BLUTEAU-LARTIGUE-G4/Security-Box/Rapports Séances/BLUTEAU Laure-Anne/SEANCE_8-BLUTEAU.pdf

BLUTEAU Laure-Anne G4

## COMPTE RENDU – SÉANCE 8

Lors de cette séance, nous avons changé notre ancienne carte esp32 Heltec Wifi Lora 32 par une esp32 WROOM. J'ai, avec cette nouvelle carte, réussi à faire communiquer l'esp32 WROOM et la arduino UNO. Nous arrivons donc maintenant à faire transiter deux données entre les cartes : une pour la validation de l'ouverture (variable "boite") et l'autre pour la réinitialisation du code, le nouveau code saisi par le propriétaire est alors envoyé (variable "code").

J'ai donc finalement rassemblé tous les codes ensemble pour n'en avoir plus que deux (un pour chaque carte) et refait marcher tous les modules ensemble. L'écran LCD ne fonctionne parfois pas mais ce "bug" doit être dû à un mauvais contact dans un fil : lorsqu'on bouge légèrement l'écran il remarche parfaitement.

Pour l'instant, je ne parviens pas à remplacer l'ancien code par le nouveau, l'ancien étant de type char : char codebon[] = "1234", et le nouveau de type String ou int, on obtient une erreur lors de la compilation (liée aux deux variables de différent type). Il faudrait alors parvenir à "écraser" l'ancien code et remplacer celui-ci par le nouveau directement dans "codebon".

Le code pour la carte maitre (esp32) est le suivant :

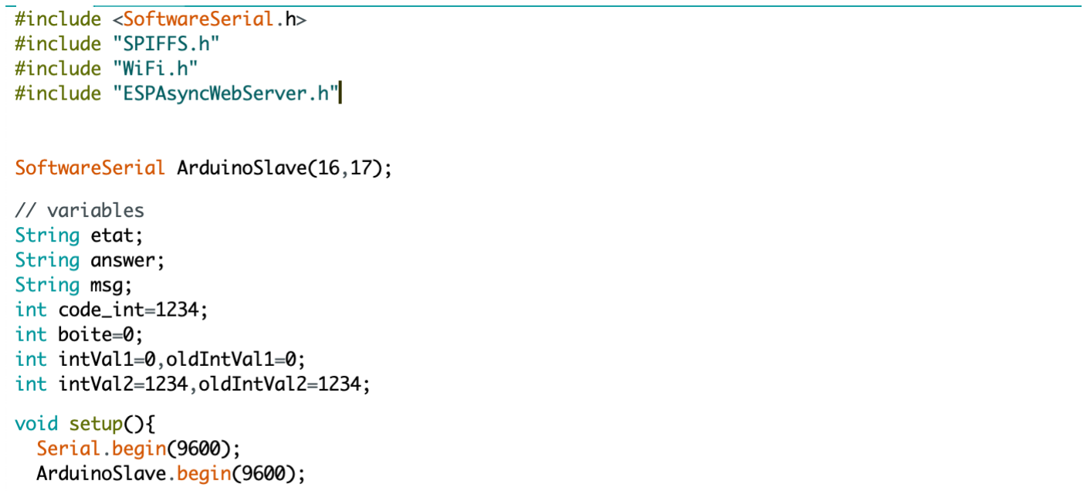
[picture p7: figure]
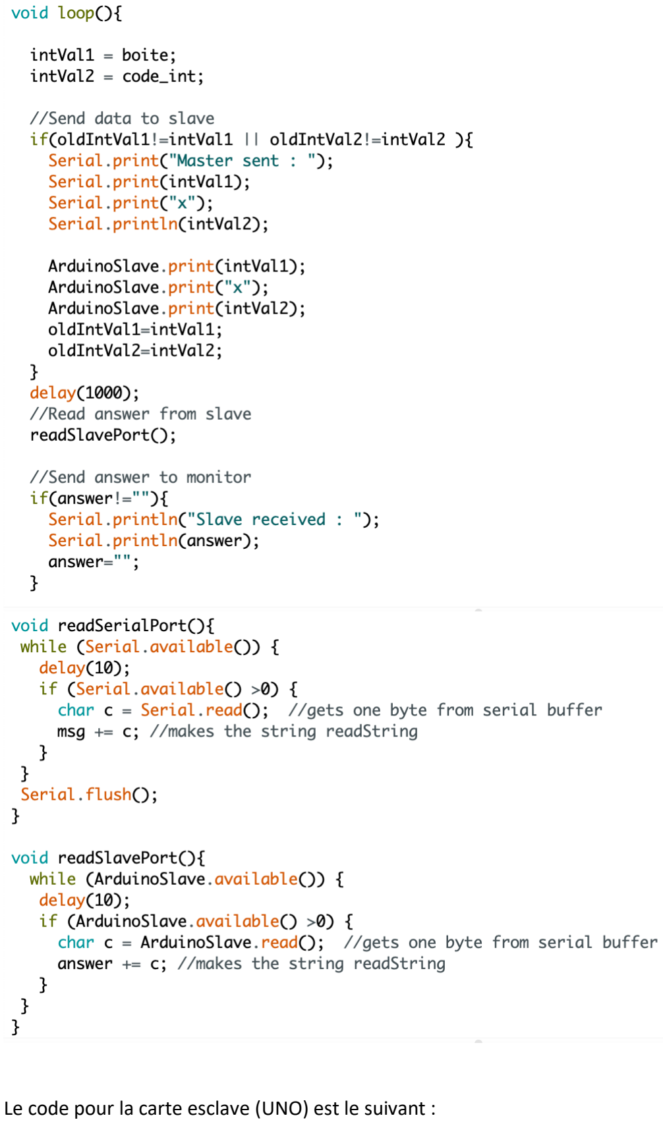
[picture p8: page 2]

Le code pour la carte esclave (UNO) est le suivant :

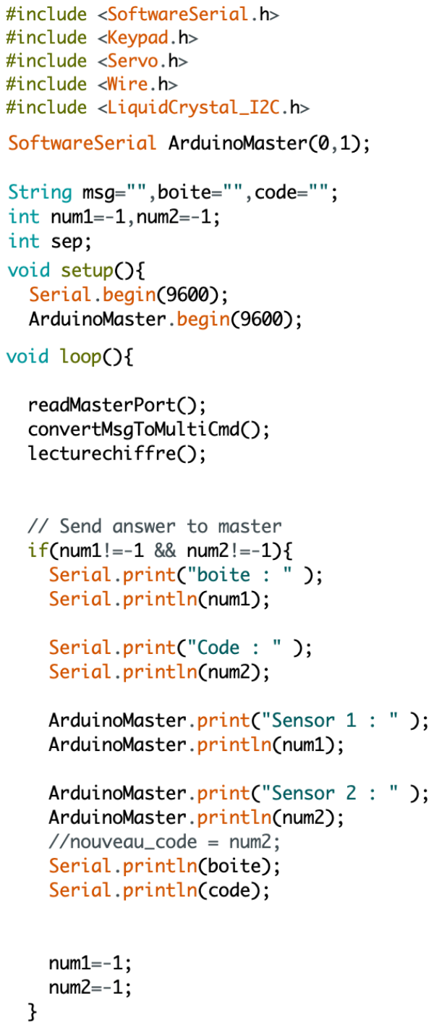
[picture p9: figure]

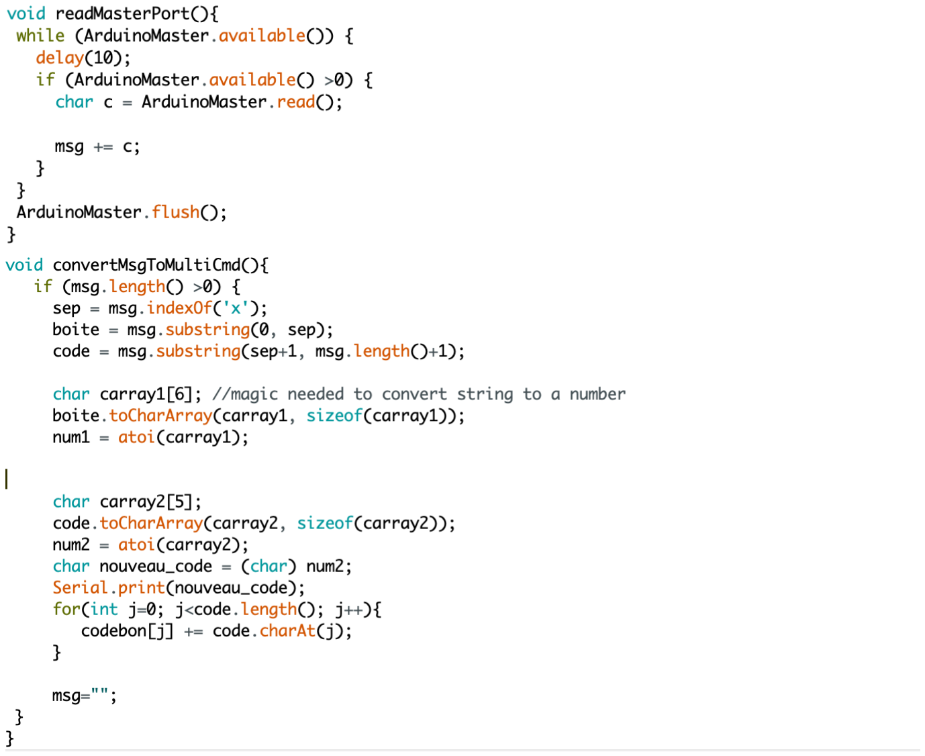
[picture p10: figure]

Les codes ci-dessus ne montrent que les parties servant à la communication entre les deux cartes.

Pour la présentation finale, une autentification pour la page html sera surement ajoutée pour que seul le propriétaire puisse s'y connecter avec des identifiants.
