BLUTEAU-LARTIGUE-G4/Security-Box/Rapports Séances/BLUTEAU Laure-Anne/SEANCE_6-BLUTEAU.pdf

BLUTEAU Laure-Anne G4

COMPTE RENDU – SÉANCE 6

Lors de cette séance, j'ai pu résoudre un problème rencontré sur la carte depuis quelques semaines, avec l'aide de monsieur Peter. Le programme amenait la carte à répéter des lignes de code en continu au lieu de se connecter au réseau. Il s'agissait enfaite d'une carte Heltec Wifi Lora 32 et non d'une Heltec Wifi Lora 32 V2, et le télé versement ne se faisait donc pas sur la bonne carte ce qui entrainait l'erreur précédente. Le problème du partage de connexion est toujours présent mais sera normalement résolu par l'ajout d'une borne wifi au projet qui permettra de connecter la carte au réseau.

J'ai également ajouté quelques lignes au programme de l'ouverture physique de la boite afin d'inclure la validation à distance du propriétaire dans le code.

CODE CARTE UNO

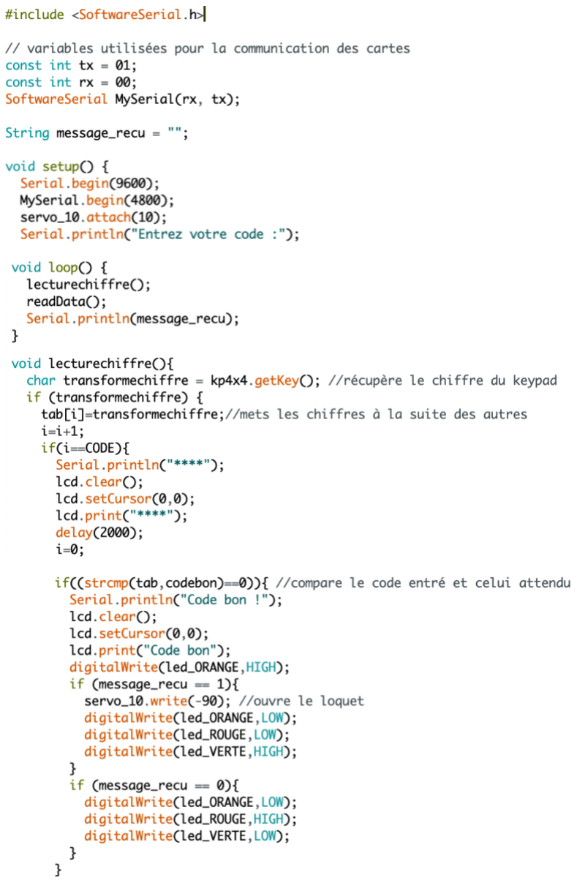
[picture p18: figure]

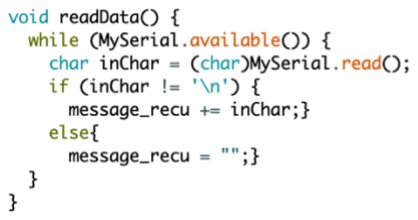
[picture p19: figure]

Ce code n'est pas celui complet, il montre simplement les lignes permettant de récupérer les informations envoyées par la carte ESP32 et de les ajouter à une variable (message_recu) sur la UNO afin d'autoriser ou non l'ouverture de la boite. Lorsque le propriétaire autorise l'ouverture à distance, l'ESP32 envoi un "1" à la UNO, dans le cas contraire un "0".

CODE CARTE ESP32

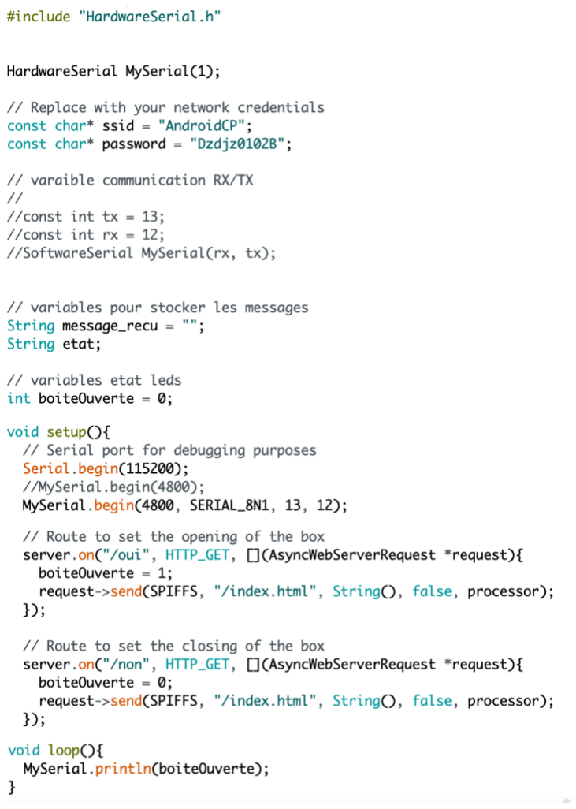
[picture p20: figure]

Ce code n'est également pas celui complet et montre seulement les lignes de codes permettant la communication. Ici lorsque la propriétaire autorise l'ouverture la variable "boiteOuverte" prend la valeur 1, à l'inverse 0. La variable est ensuite envoyée sur "MySerial", moniteur série commun aux deux cartes permettant le transfert de données de l'ESP32 vers la UNO.

Monsieur Peter nous a également conseillé de tout rassembler sur l'ESP32 afin d'éviter la communication entre les deux cartes (qui ne marche pas encore) et de n'en garder qu'une. Nous avions décidé d'utiliser deux cartes par peur de manque de place mais il s'avère que tous les appareils pourraient être câblés sur l'ESP32 mais aussi car nous n'avions pas de bibliothèque compatible avec la carte Wifi pour certains composants comme le servo moteur. Nous essaierons donc pendant les vacances de tout rassembler sur une carte ou à default de faire marcher la communication.

Nous avons également prévu, avec Elisa pour qu'il ne reste plus qu'aux dernières séances à régler les derniers problèmes et tout installer dans la boite.
