BLUTEAU-LARTIGUE-G4/Security-Box/Rapports Séances/LARTIGUE Elisa/SEANCE 5 LARTIGUE PROJET ARDUINO.pdf

### SEANCE 5 PROJET ARDUINO – ELISA LARTIGUE

Cette séance était pour nous une séance de groupe, l’occasion de nous montrer les problèmes respectifs que nous rencontrions et de nous mettre d’accord sur les modalités de la création de la boîte.

Laure Anne rencontrait quelques soucis pour faire discuter la carte ESP32 avec la carte UNO. L’objectif était de déclencher l’ouverture de la boîte en fonction d’une information envoyée de l’ESP32 à la carte UNO. Pendant qu’elle tentait plusieurs bibliothèques et mixait plusieurs codes, j’ai de mon côté, travaillé sur l’état des LED en fonction de la décision envoyée par l’ESP32.

Montage

La led verte ne figure pas sur ce montage car elle ne présente pas d’intérêt en l’absence du code de l’ESP32. En effet, la led verte s’allume si et seulement si le code tapé sur le digicode est le bon et que le propriétaire valide l’action. Ce montage ne correspond qu’au code de la carte uno.

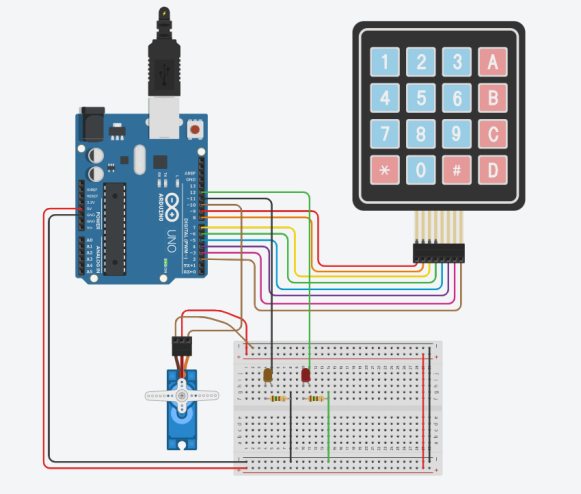
[picture p26: figure]

J’ai joué sur la couleur des leds en fonction du code tapé. Lorsque le code tapé est bon, la led orange s’allume jusqu’à validation par le propriétaire (dans ce cas la led orange s’éteint, la led verte s’allume et la porte s’ouvre) et si le code est faux, la led rouge s’allume pendant les trois essais supplémentaires disponibles, et s’éteint à la fin des trois essais si le code tapé reste faux (ou est remplacé par la led orange si le code tapé est bon et que l’on attend la réponse du propriétaire).

Monsieur Peter nous a rejoint en réponse à un de nos mails et après lecture de notre code, nous a conseillé d’essayer une nouvelle bibilothèque : Serial.hardware. Nous devons nous pencher sur cette bibliothèque pour savoir comment elle fonctionne.

Nous nous sommes ensuite rendues dans le fablab afin de nous mettre d’accord sur les dimensions et les matériaux que nous utiliserons la semaine prochaine pour la conception de la boîte. Nous avons choisi de faire notre boîte dans un bois épais que nous peindrons en noir. D’une hauteur de 20 cm, il présentera deux compartiments. Un pour le matériel électronique et l’autre pour le coffre.

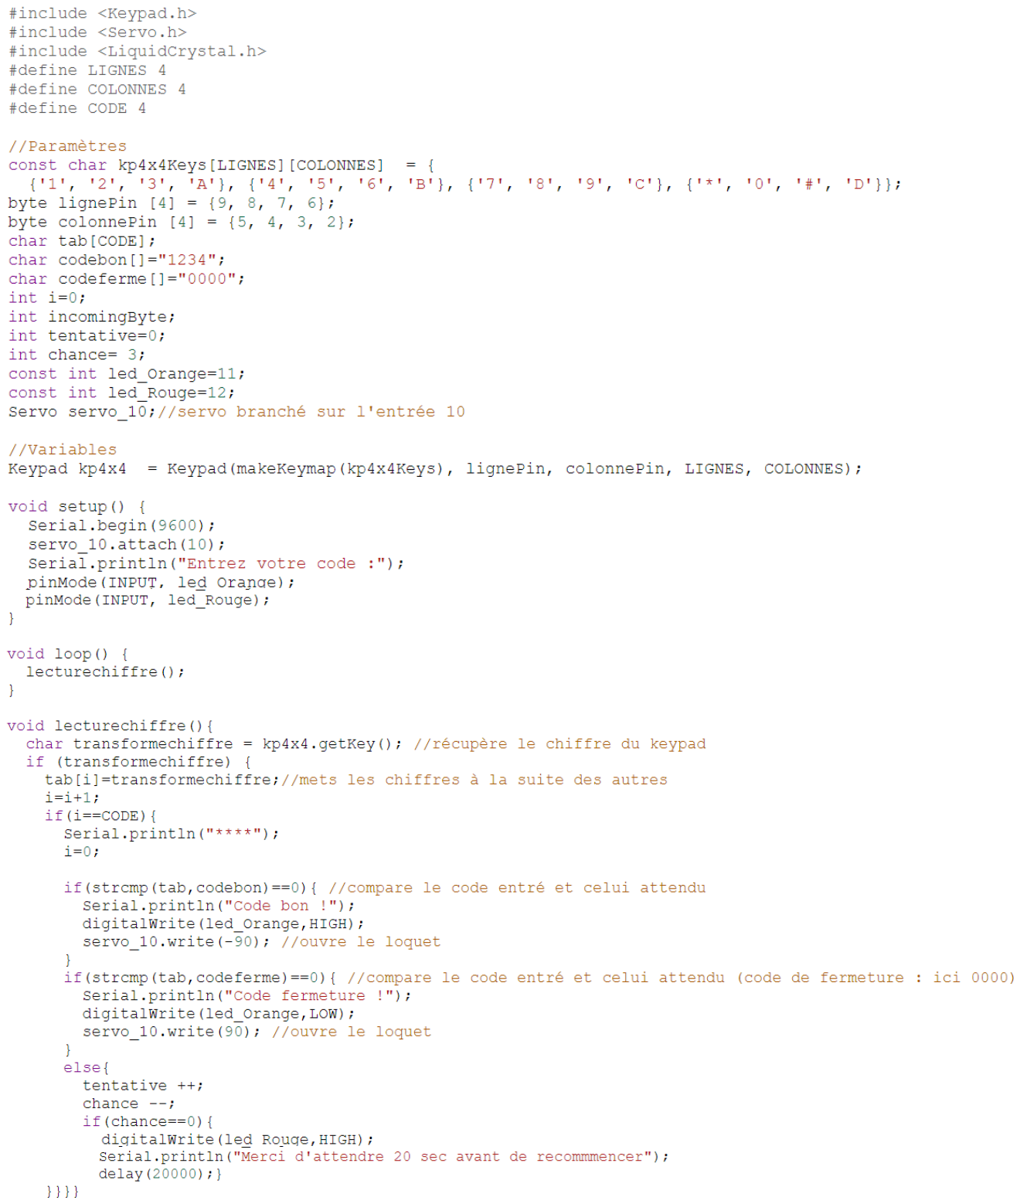
[picture p27: figure]
