BLUTEAU-LARTIGUE-G4/Security-Box/Rapports Séances/LARTIGUE Elisa/SEANCE 4 LARTIGUE PROJET ARDUINO.pdf

### SEANCE 4 PROJET ARDUINO – ELISA LARTIGUE

Cette séance était dédiée à la présentation du projet et du réglages de nos derniers problèmes. Nous avions à l’origine deux cartes, une carte ESP8266 (qui gérait l’allumage d’une LED à distance) et une carte arduino (qui en fonction de la LED allumée, ouvrait ou non le servo moteur). Toutefois, Monsieur Peter ne comprenait pas l’utilisation de ces deux cartes et nous avait conseillé de tout regrouper sur une troisième carte ESP32 pour éviter que nos programmes prennent trop de temps à charger. Toutefois, la librairie du servo moteur et du keypad ne semblent pas convenir à cette carte. Nous avons donc gardé les deux cartes que nous essayons de faire dialoguer toutes les deux grâce au port TX et RX.

LED ORANGE

J’ai tout d’abord ajoutée une LED orange au montage. Une fois le code correctement tapé par l’utilisateur, une LED orange s’allume, dans l’attente de la réponse du propriétaire du coffre qui valide, ou non, son ouverture.

Code ajouté + montage:

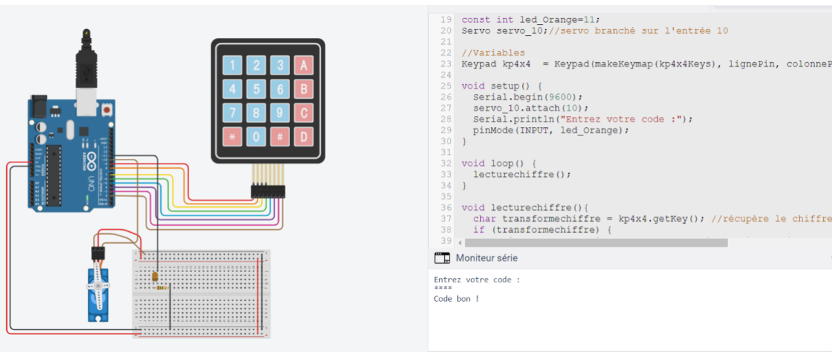
[picture p28: figure]

Modification du code : simple ajout d’une LED orange qui s’allume lorsque le code est bon comme vu en TD au début du module. Ici la LED est allumée car le code tapé est le bon.

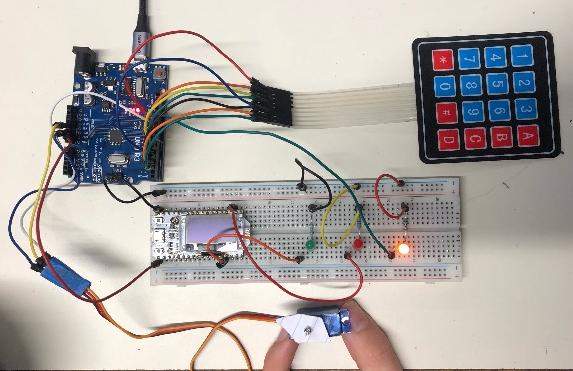
[picture p29: figure]

FERMETURE DU COFFRE

J’ai ensuite ajouté un code au code originel afin que le coffre puisse être fermé lorsque l’utilisateur tape « 0000 ».

Modification du code :

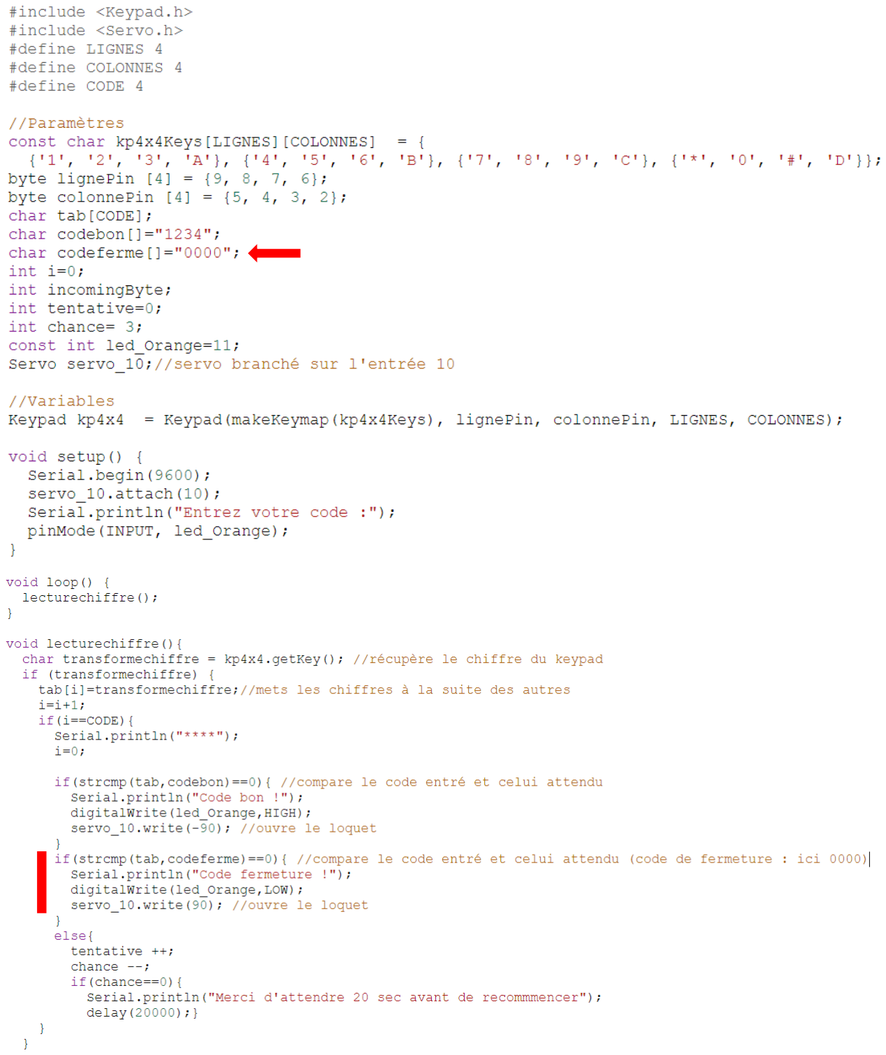
[picture p30: figure]

VOIR PAGE SUIVANTE

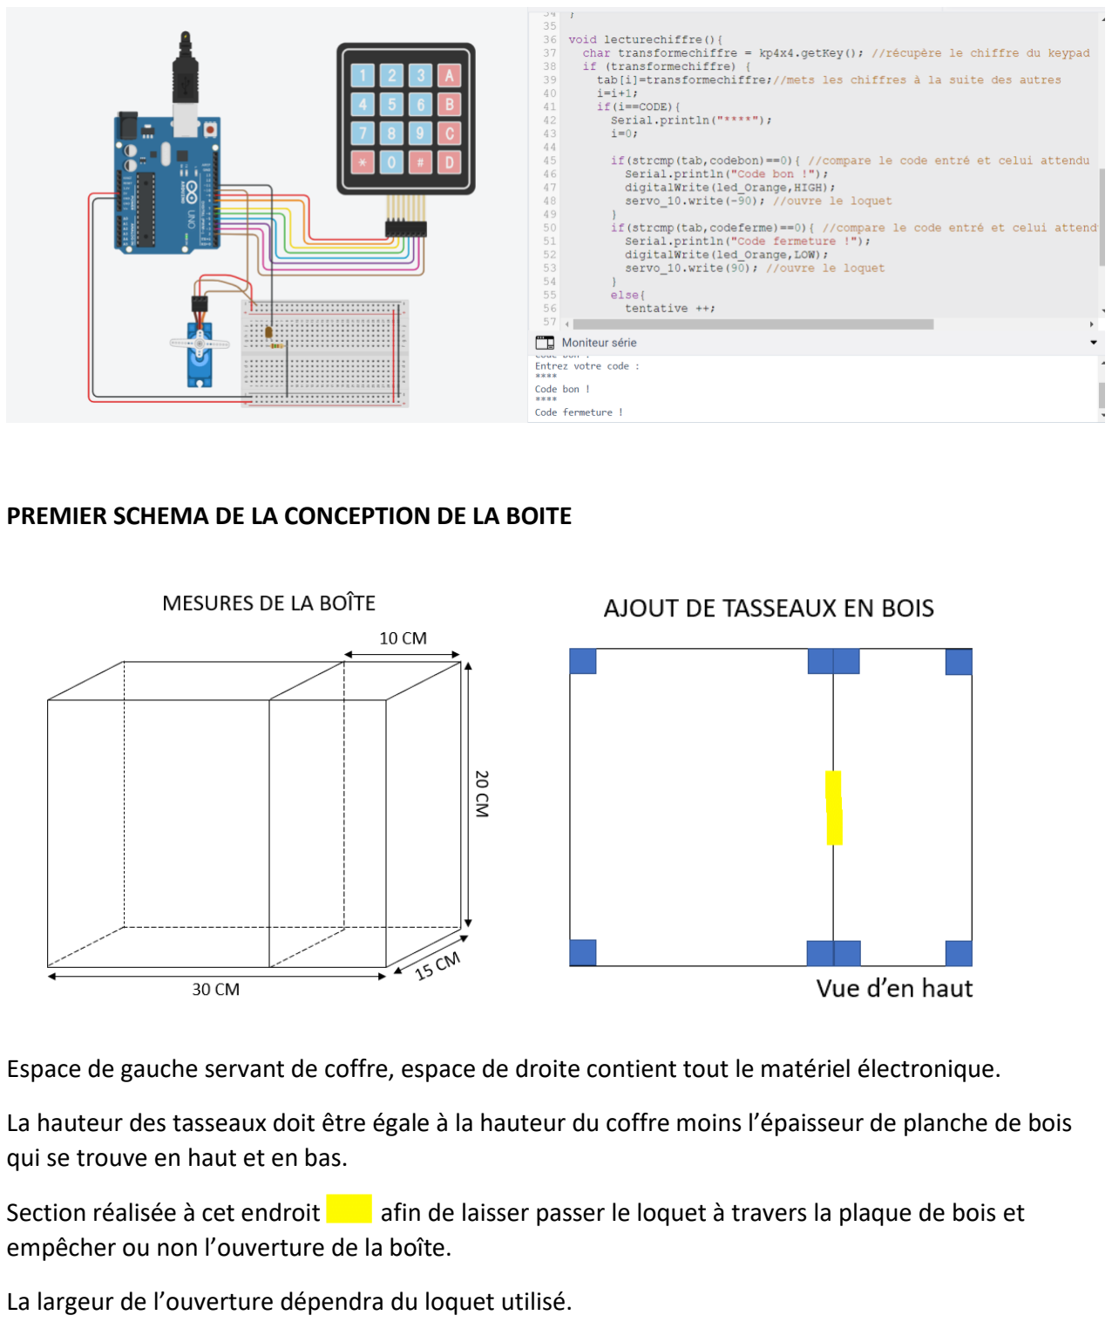
[picture p31: page 3]

PREMIER SCHEMA DE LA CONCEPTION DE LA BOITE

Espace de gauche servant de coffre, espace de droite contient tout le matériel électronique.

La hauteur des tasseaux doit être égale à la hauteur du coffre moins l’épaisseur de planche de bois qui se trouve en haut et en bas.

Section réalisée à cet endroit afin de laisser passer le loquet à travers la plaque de bois et empêcher ou non l’ouverture de la boîte.

La largeur de l’ouverture dépendra du loquet utilisé.
