BLUTEAU-LARTIGUE-G4/Security-Box/Rapports Séances/LARTIGUE Elisa/SEANCE 3 LARTIGUE PROJET ARDUINO.pdf

### SEANCE 3 PROJET ARDUINO – ELISA LARTIGUE

Pour cette séance, je devais m’occuper de permettre à l’utilisateur de modifier le mot de passe pour ouvrir le coffre, à distance. Prenons l’exemple de Monsieur X qui loue son appartement à Nice pendant les vacances. Monsieur X est à Paris. Le coffre se trouve devant l’appartement à loué et contient les clés. Une famille loue son appartement du 1er juin au 4 juin. Le 5, pour éviter que cette même famille ait la possibilité de revenir dans l’appartement alors qui est loué par quelqu’un d’autre, Monsieur X a la possibilité de changer le mot de passe du coffre.

SCHEMA EXPLICATIF :

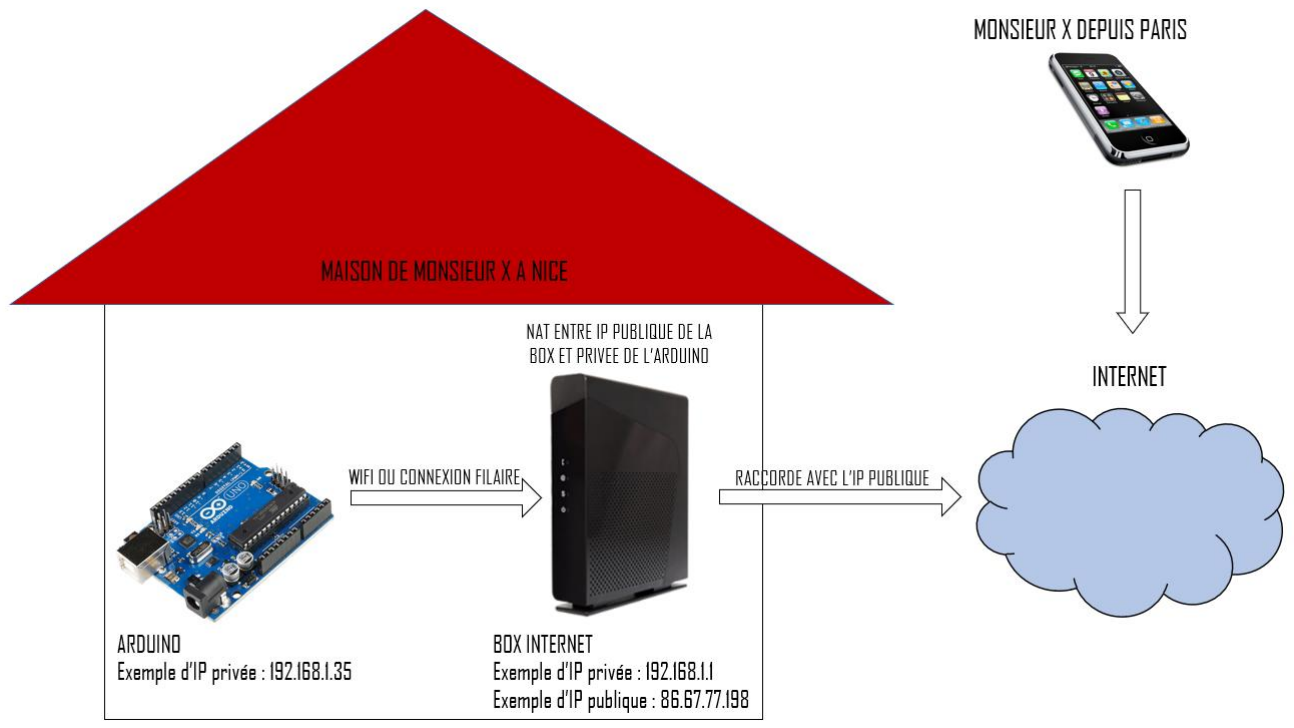
[picture p36: figure]

1. Monsieur X se rend sur internet et tappe dans la barre de recherche son adresse IP publique de la box sous la forme suivante « http:// 86.67.77.198 (https://whatismyipaddress.com/ip/86.67.77.198) ».
2. La box, étant accessible sur Internet et l’adresse IP publique de la box étant natée avec l’adresse privée de l’arduino, Monsieur X peut « agir » sur l’arduino (ici changer le mot de passe attendue par notre coffre).

J’ai ensuite créé une page HTML avec un espace prévu afin que l’utilisateur entre son nouveau mot de passe. Une fois le nouveau mot de passe enregistré, il est envoyé à l’arduino via l’URL.

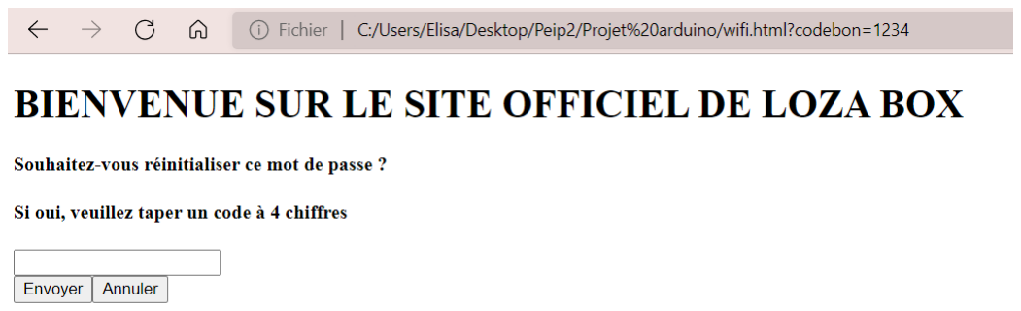
[picture p37: figure]

Ici j’ai tapé le code 1234, et on peut voir qu’il apparait dans le variable appelée codebon.

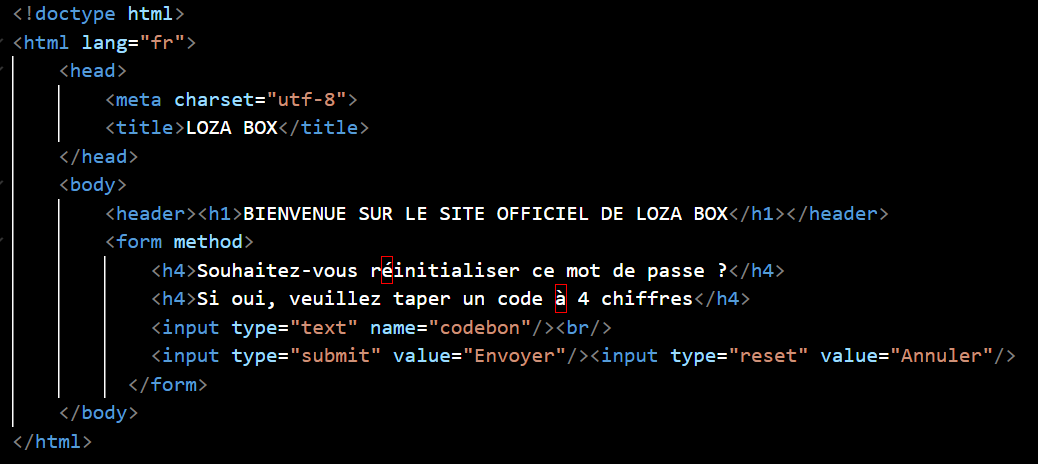
[picture p38: figure]

Je me suis alors rendu compte que si une personne réussissait à obtenir l’adresse IP publique de l’appartement de Monsieur X, il pourrait hacker le système. J’ai donc cherché à ajouter une vérification d’identité avant que l’utilisateur puisse modifier le mot de passe.

CODE SUIVANT :

J’ai d’abord défini les paramètres d’identification : nom d’utilisateur et mot de passe.

const char* http_username = "admin";
const char* http_password = "admin";

Je dois tester ce code pour permettre l’identification du propriétaire avant qu’il confirme ou refuse l’ouverture de la boîte. J’attends la semaine prochaine pour le tester sur notre code final.

server.on("/", HTTP_GET, [](AsyncWebServerRequest *request){ if(!request->authenticate(http_username, http_password))
return request->requestAuthentication(); request->send_P(200, "text/html", index_html, processor);
});

server.on("/logout", HTTP_GET, [](AsyncWebServerRequest *request){ request->send(401);
});

server.on("/logged-out", HTTP_GET, [](AsyncWebServerRequest *request){ request->send_P(200, "text/html", logout_html, processor);
});

server.on("/update", HTTP_GET, [] (AsyncWebServerRequest *request) { if(!request->authenticate(http_username, http_password))
return request->requestAuthentication();

String inputMessage;
String inputParam;
// GET input1 value on <ESP_IP>/update?state=<inputMessage> if (request->hasParam(PARAM_INPUT_1)) {
inputMessage = request->getParam(PARAM_INPUT_1)->value(); inputParam = PARAM_INPUT_1;
digitalWrite(output, inputMessage.toInt());
}
else {
inputMessage = "No message sent”; inputParam = "none";
}
Serial.println(inputMessage); request->send(200, "text/plain", "OK"); });

// Start server
server.begin();

Nous avons ensuite, avec Laure Anne, testé nos deux codes ensemble. Si Monsieur X accepte l’ouverture de la boîte à distance alors une LED verte s’allume sur notre coffre. Pour que celui-ci s’ouvre, la présence d’un code non erroné et de la LED verte allumée sont nécessaires.

Laure Anne simulait la confirmation de l’ouverture par Monsieur X en allumant la LED verte via internet. J’ai ajouté cette condition pour l’ouverture du servomoteur.

MONTAGE + CODE (modification des conditions à la ligne 9):

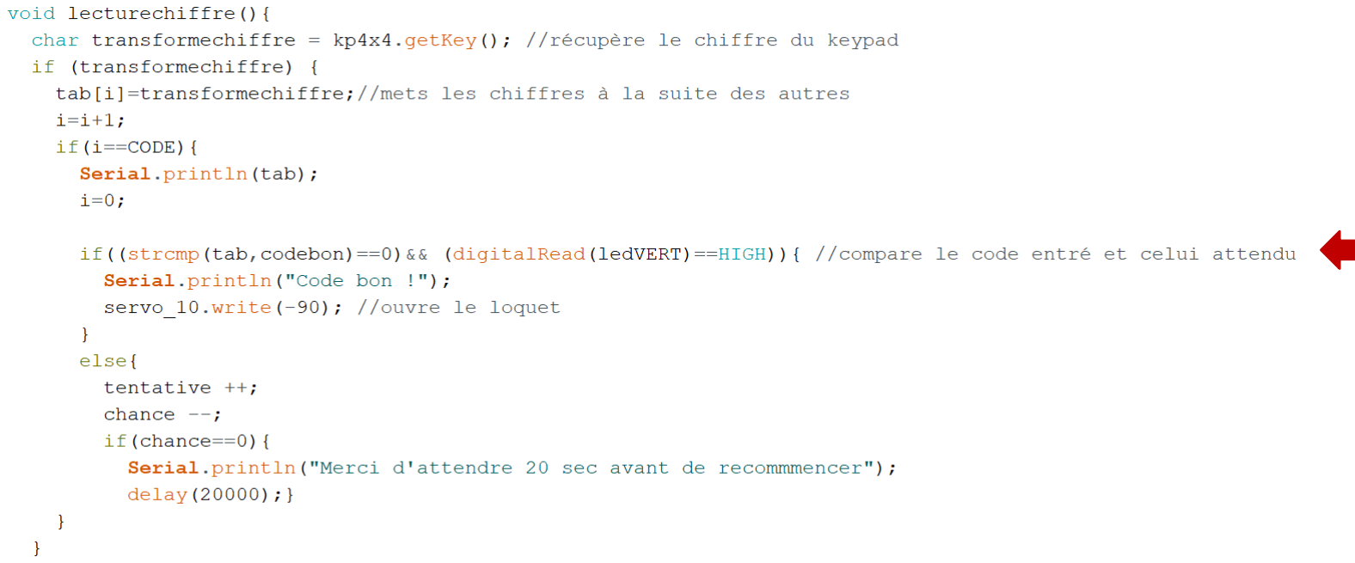
[picture p39: figure]
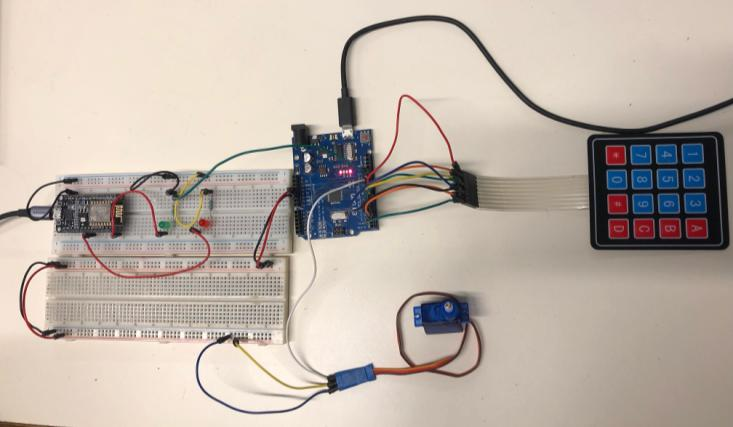
[picture p40: figure]

Problème rencontré : une fois nos deux codes liés, la page de Laure Anne prenait beaucoup de temps à charger, il nous faut donc au prochain cours mettre nos deux codes sur une même page et choisir une même carte commune. Nous avons choisi une ESP32.
