BLUTEAU-LARTIGUE-G4/Security-Box/Rapports Séances/LARTIGUE Elisa/SEANCE 2 LARTIGUE PROJET ARDUINO.pdf

### SEANCE 2 PROJET ARDUINO – ELISA LARTIGUE

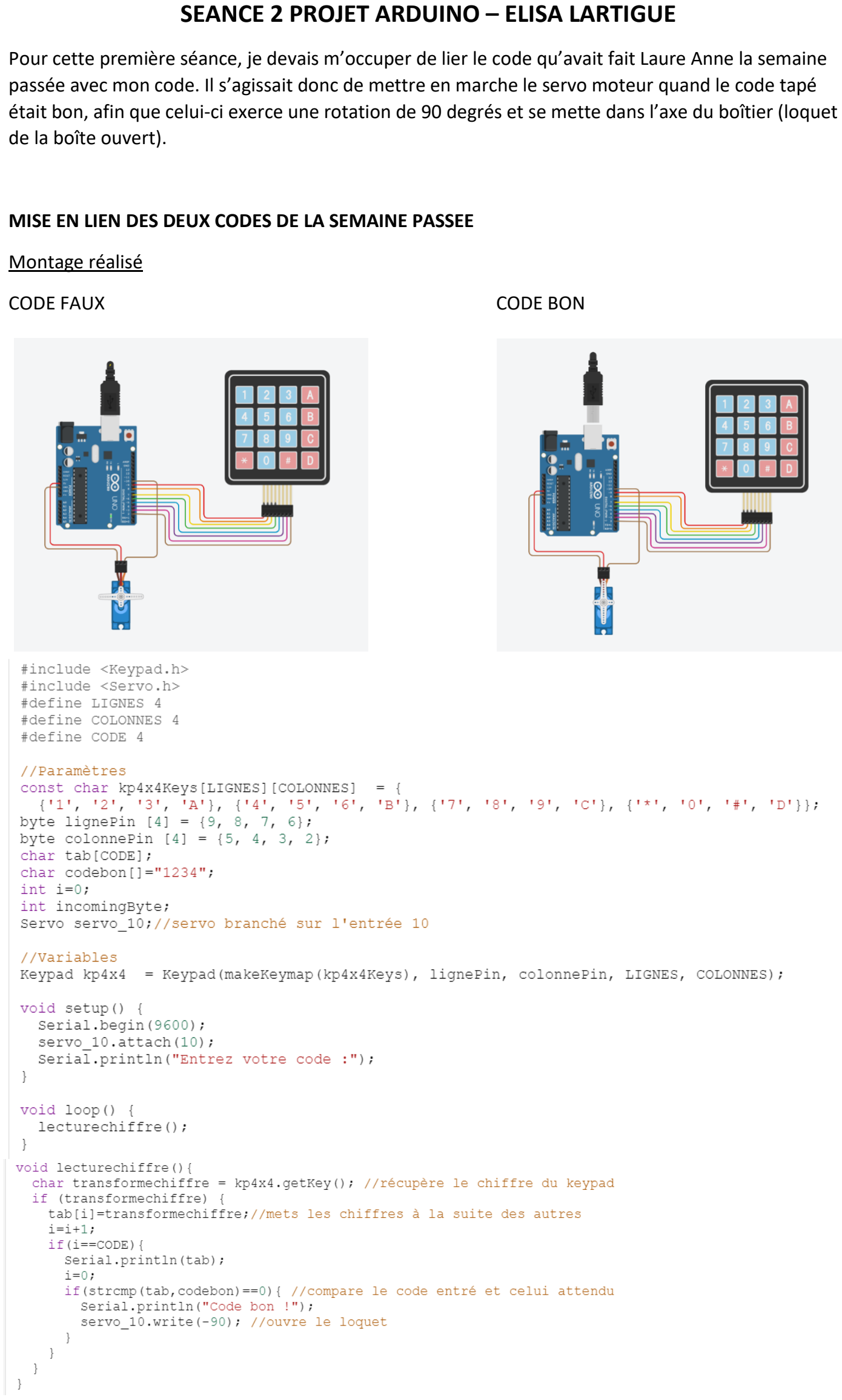
[picture p44: page 1]

Pour cette première séance, je devais m’occuper de lier le code qu’avait fait Laure Anne la semaine passée avec mon code. Il s’agissait donc de mettre en marche le servo moteur quand le code tapé était bon, afin que celui-ci exerce une rotation de 90 degrés et se mette dans l’axe du boîtier (loquet de la boîte ouvert).

MISE EN LIEN DES DEUX CODES DE LA SEMAINE PASSEE

Montage réalisé

CODE FAUX | CODE BON

Pour ce code, j’ai simplement ordonné au servo moteur de réaliser une rotation de 90 degrés lorsque le code était bon. J’ai donc entré dans la condition du code bon (servo_10.write(-90) ;)

Mixer les deux codes de la semaine passée s’est révélé plus rapide que prévu. J’ai donc décidé de rajouter quelques options :

-bloquer la possibilité de tenter le code pendant 20 secondes (pour que ça ne soit pas trop long pour les tests, 5min dans la réalité) après trois tentatives de code erroné.

-cacher le code à l’aide d’étoiles.

AJOUT D’OPTIONS

1) Bloquer la possibilité de tenter le code pendant 20 secondes après trois tentatives de code erroné.

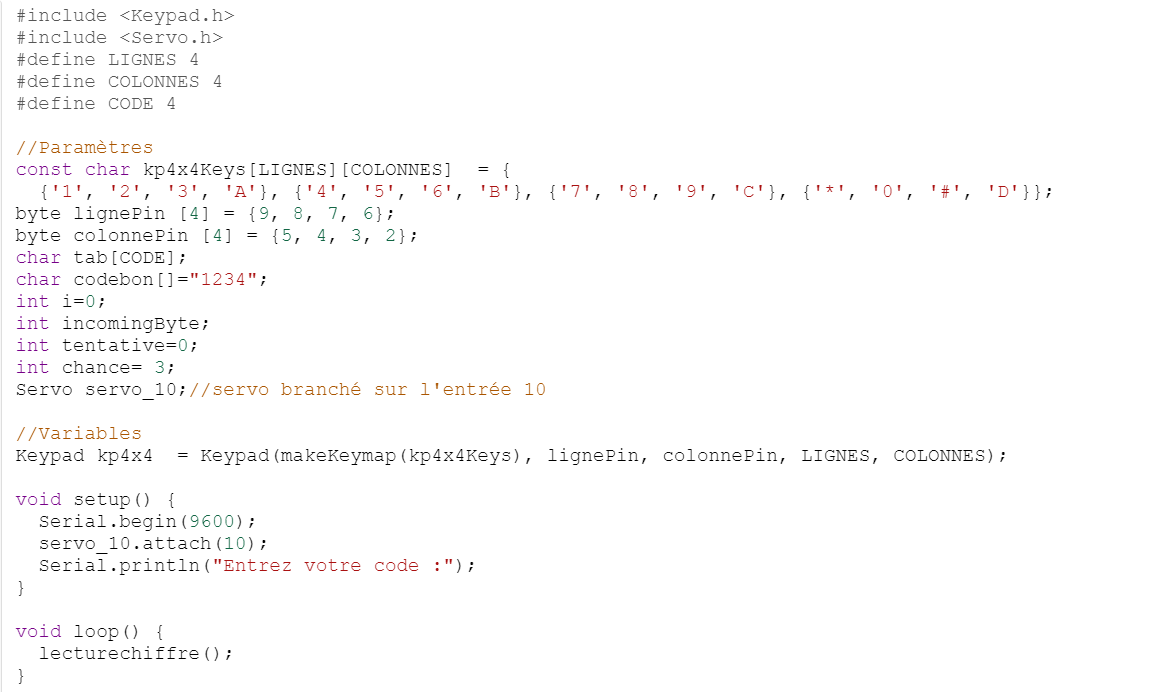
[picture p45: figure]
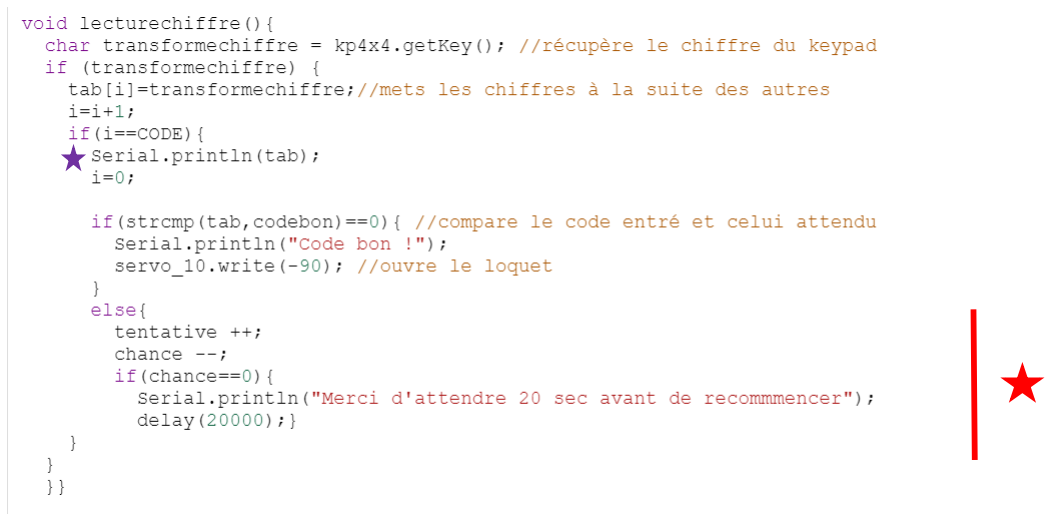
[picture p46: figure]

Ajout de deux variables : chance (qui me permet de bloquer l’accès au code quand trop de tentatives erronées) et tentatives (qui me servira plus tard pour l’écran LCD).

Ajout d’un délai de 20 secondes lorsque le nombre de chances restantes vaut 0.

Résultat obtenu :

2) Cacher le code à l’aide d’étoiles.

Simple modification de la ligne en Serial.println(« **** ») ;

Résultat obtenu :

3) Demander de retaper le code pour fermer le servomoteur

Modification de cette partie du code. J’ai fixé le code de fermeture au code suivant : 4321.
On me demande bien de retaper le code pour refermer. Mais l’ordinateur ne reconnaît pas le code bon à la fermeture, et n’actionne donc pas le servomoteur. Je dois régler ce souci pour le prochain cours.

Montages que je n’avais pas réussi à faire la semaine dernière, dû à un problème de bibliothèque (mauvaise bibliothèque téléchargée)

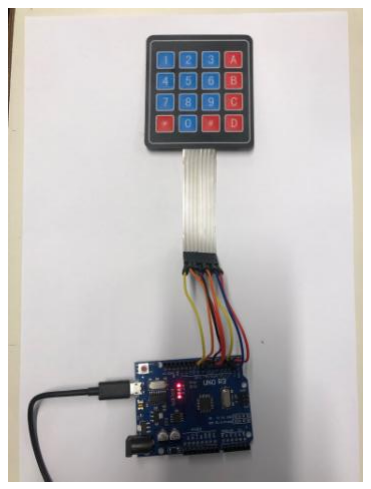
[picture p47: figure]

1) Premier montage : montage du keypad seul.

Permet d’obtenir les chiffres tapés sur le keypad, sur le terminal.

2) Second montage : montage du keypad seul avec le servomoteur.

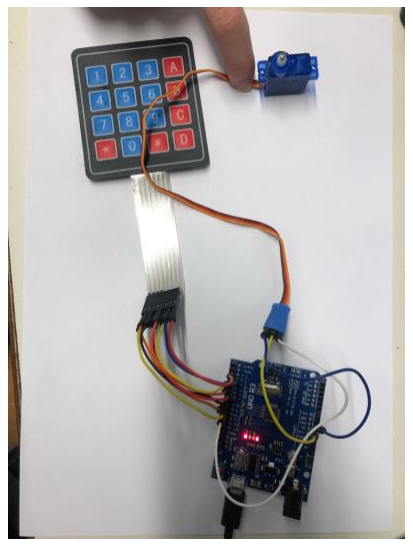
[picture p48: figure]

Permet de faire tourner le servomoteur(ouverture/fermeture de la boîte) en fonction du code tapé.
