BLUTEAU-LARTIGUE-G4/Security-Box/PRESENTATION_ARDUINO.pdf

# LOZA SECURITY BOX

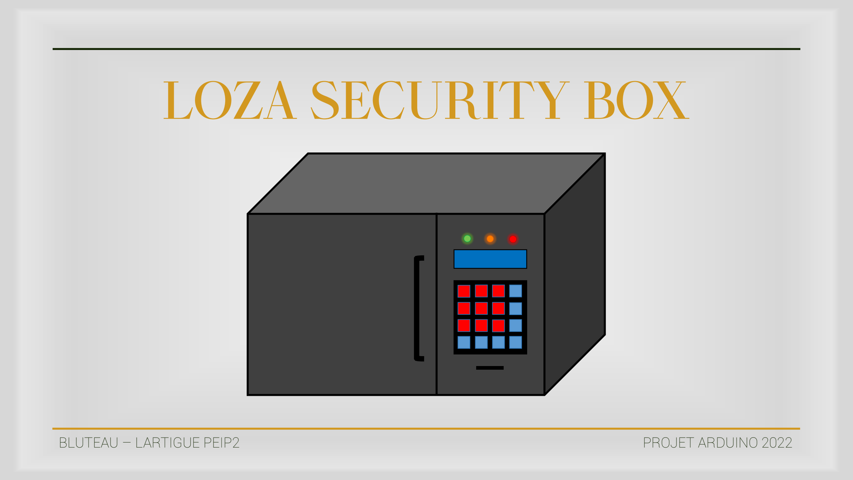
[picture p52: page 1]

BLUTEAU – LARTIGUE PEIP2 | PROJET ARDUINO 2022

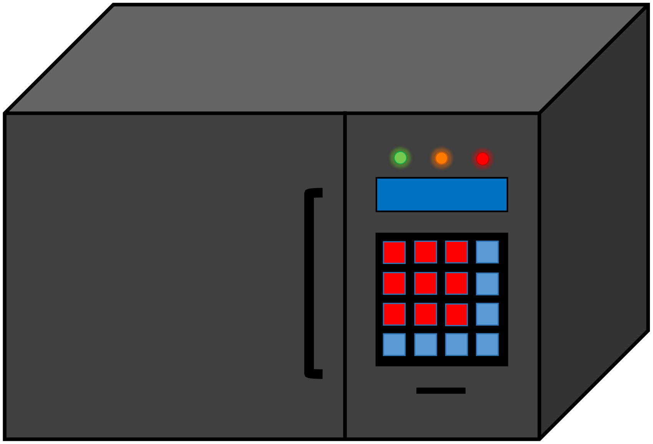
[picture p53: figure]

BLUTEAU – LARTIGUE PEIP2 | PROJET ARDUINO 2022

PRÉSENTATION GÉNÉRALE

BOITE SÉCURISÉE

SYSTÈME LUMINEUX

CODE DIGITAL

COMMUNICATION PAR WIFI
AVEC LE PROPRIÉTAIRE

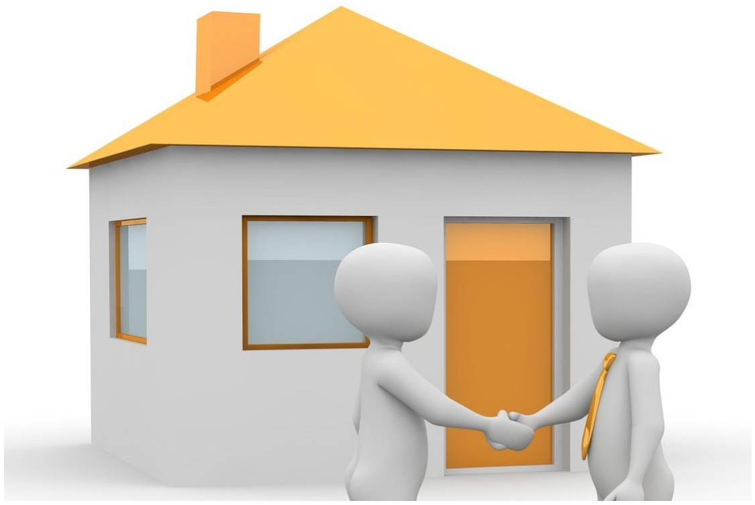
[picture p54: figure]

BLUTEAU – LARTIGUE PEIP2 | PROJET ARDUINO 2022

UTILISATIONS POSSIBLES

La LOZA SÉCURITY BOX pourrait être utilisée :

pour la location saisonnière afin de faire passer les clés du propriétaire au locataire ;

à des fins personnelles.

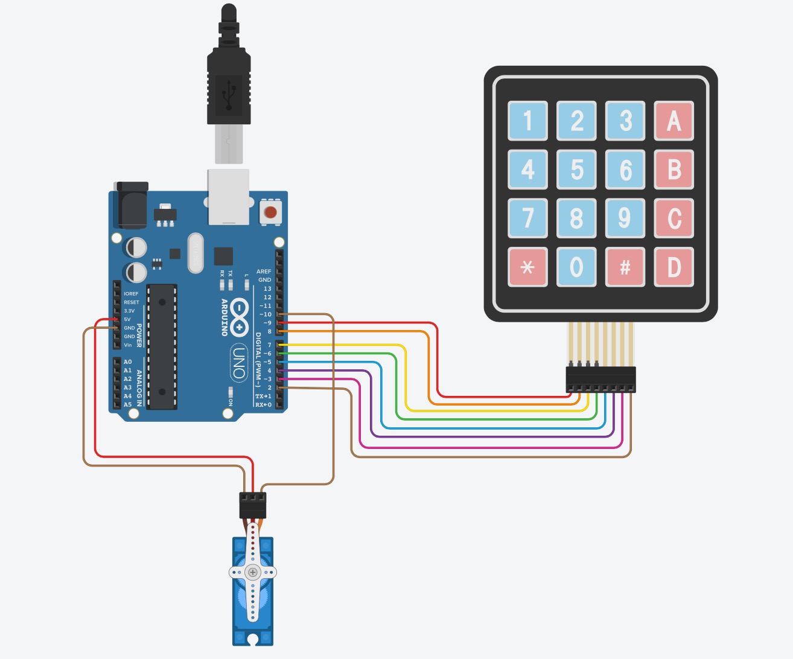
[picture p55: figure]

BLUTEAU – LARTIGUE PEIP2 | PROJET ARDUINO 2022

ÉTAPES DE RÉALISATION

1ère ÉTAPE : SYSTÈME D’OUVERTURE ET DE FERMETURE

OUVERTURE

FERMETURE

Lorsqu’un code bon est saisit, le servomoteur effectue une rotation de 90° et ouvre ainsi la boîte.

Lorsque le code fermeture est saisit, le servomoteur effectue une rotation de 90° bloquant ainsi la porte.

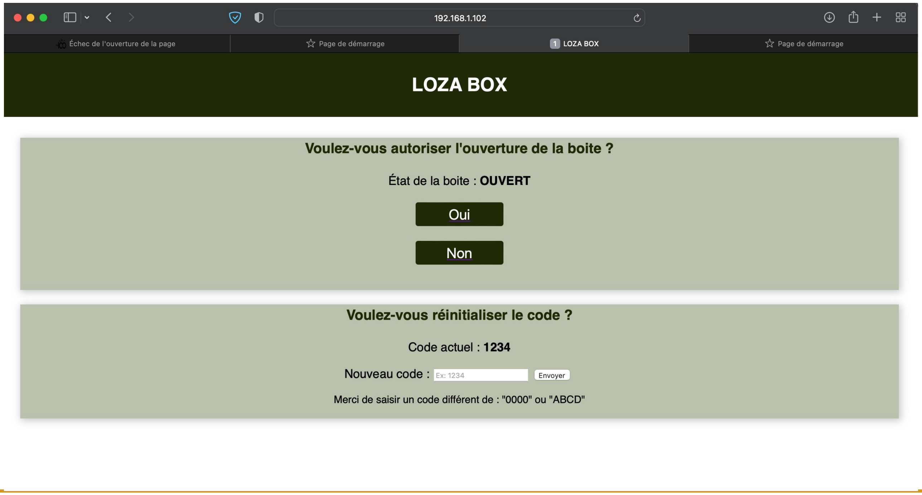
[picture p56: figure]

BLUTEAU – LARTIGUE PEIP2 | PROJET ARDUINO 2022

ÉTAPES DE RÉALISATION

2ème ÉTAPE : CRÉATION D’UNE CONNEXION WIFI

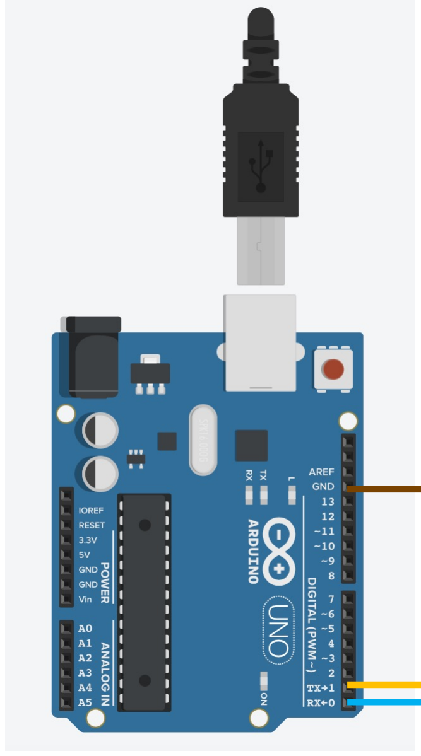
[picture p57: figure]
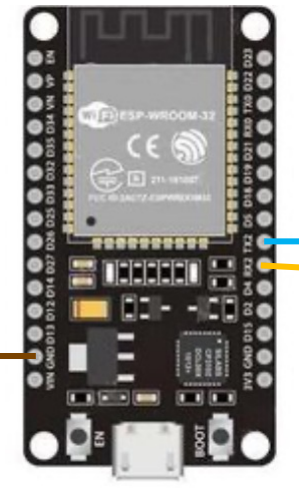
[picture p58: figure]

BLUTEAU – LARTIGUE PEIP2 | PROJET ARDUINO 2022

ÉTAPES DE RÉALISATION

3ème ÉTAPE : CONNEXION ENTRE LES DEUX CARTES

INFORMATIONS À ENVOYER

ESP32

UNO

Nouveau code | Validation ou non de l’ouverture de la boite

Lecture et implémentation dans des variables

+

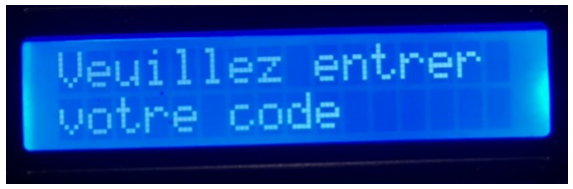
[picture p59: figure]
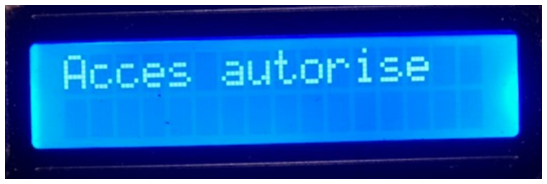
[picture p60: figure]
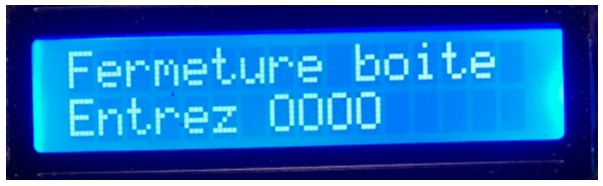
[picture p61: figure]

BLUTEAU – LARTIGUE PEIP2 | PROJET ARDUINO 2022

ÉTAPES DE RÉALISATION

4ème ÉTAPE : PERFECTIONNEMENT DU SYSTÈME

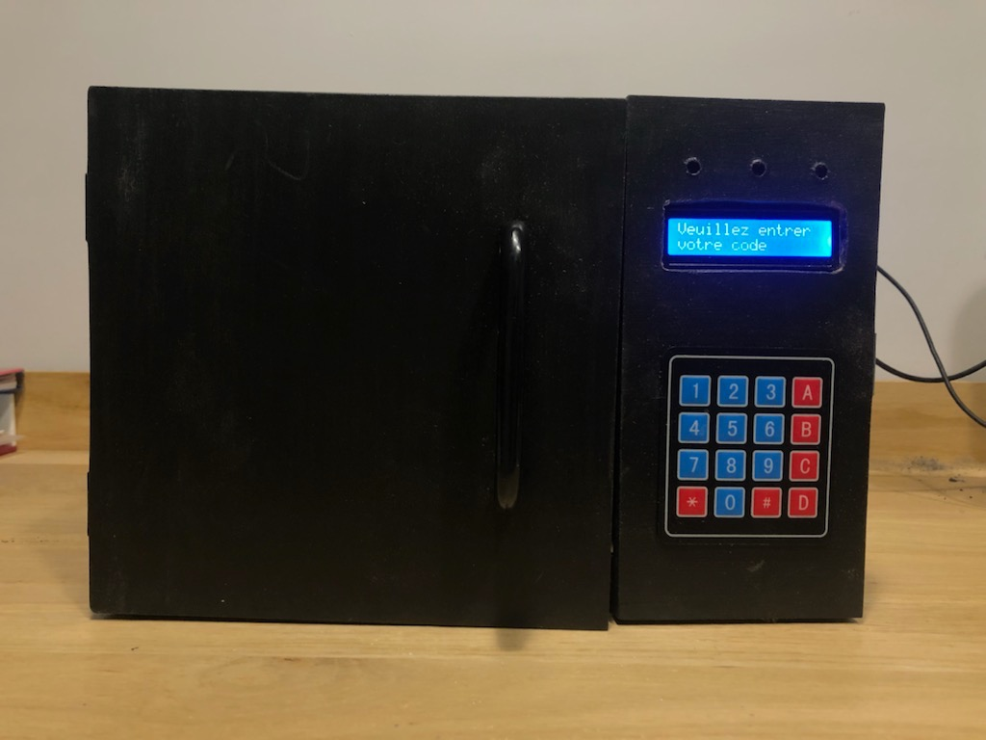
[picture p62: figure]

BLUTEAU – LARTIGUE PEIP2 | PROJET ARDUINO 2022

ÉTAPES DE RÉALISATION

5ÈME ÉTAPE : MONTAGE DE LA BOITE

VUE DU DESSUS

Partie coffre | Matériel électronique

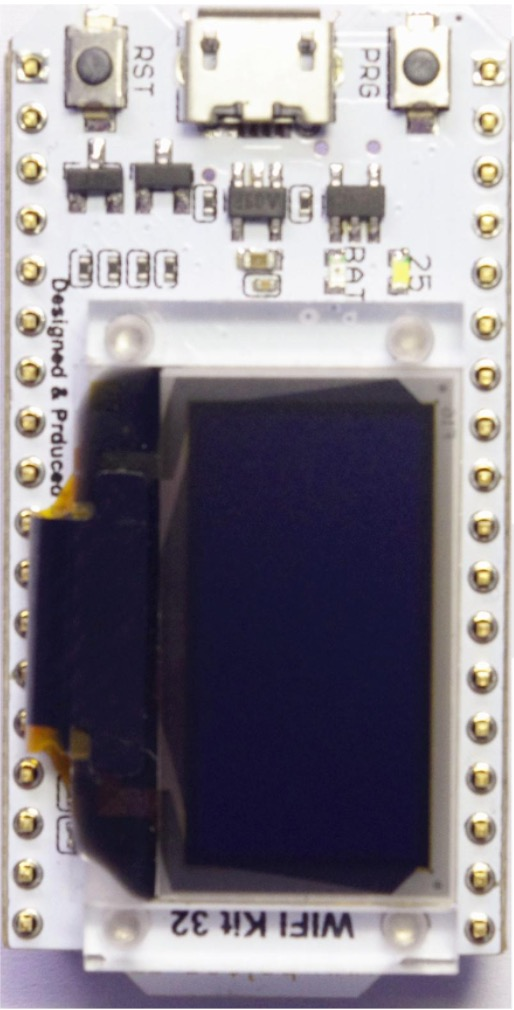
[picture p63: figure]
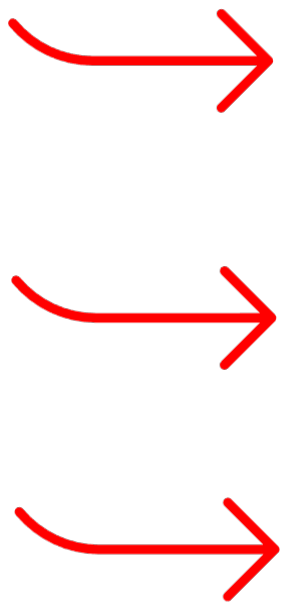
[picture p64: figure]

BLUTEAU – LARTIGUE PEIP2 | PROJET ARDUINO 2022

PROBLÈMES RENCONTRÉS

Heltec wifi Lora

PAS COMPATIBLE AVEC PLUSIEURS BIBLIOTHÈQUES

CONNEXION RX/TX DIFFICILE

N’EST PAS UNE V2 MAIS UNE V1

Nous avons finalement changé de carte pour passer sur une ESP32 WROOM.

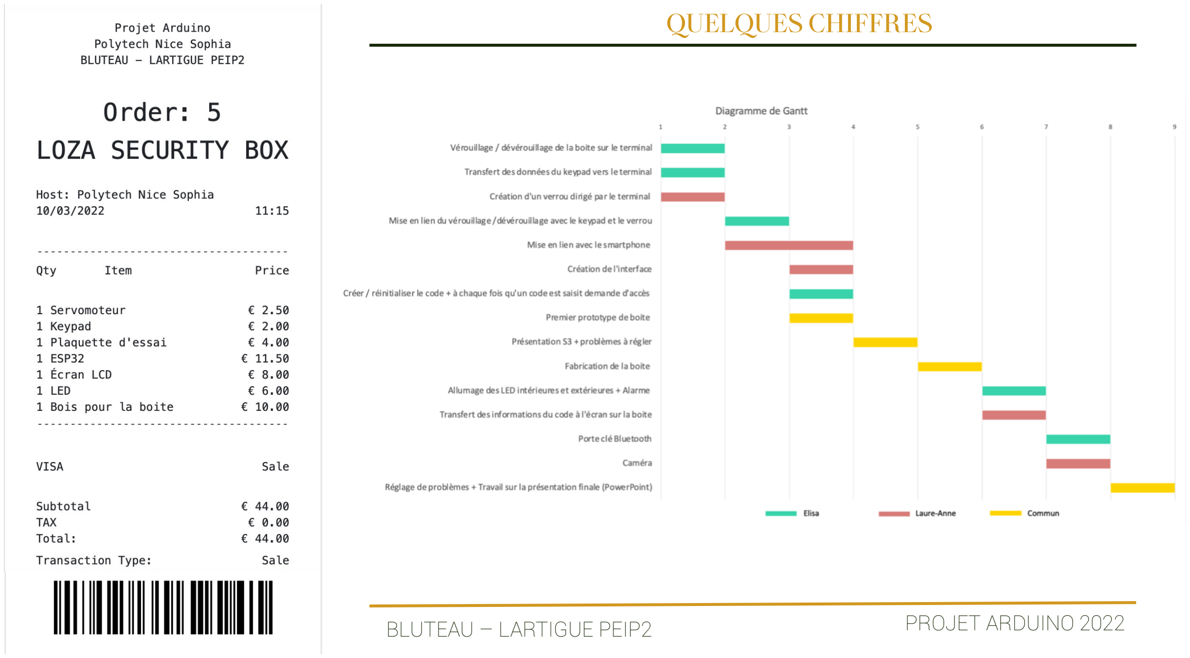
[picture p65: page 10]

BLUTEAU – LARTIGUE PEIP2 | PROJET ARDUINO 2022

QUELQUES CHIFFRES

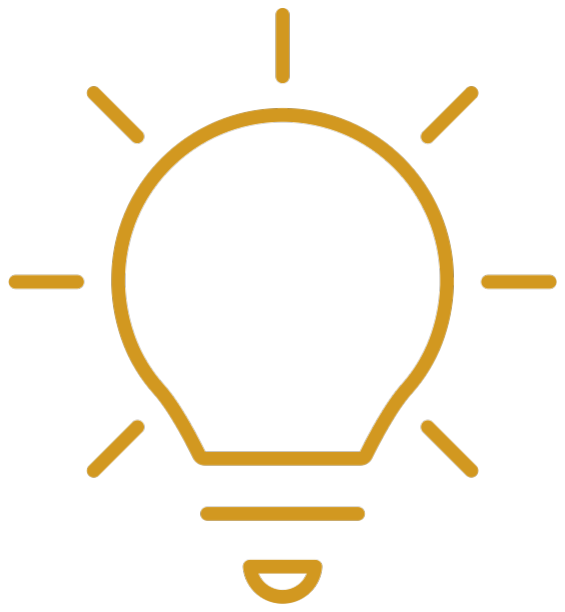
[picture p66: figure]
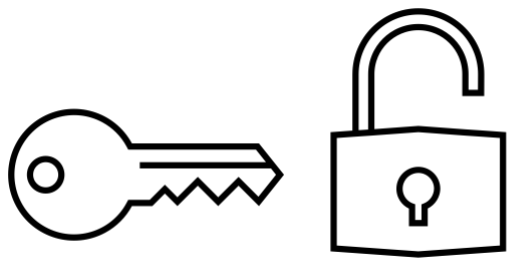
[picture p67: figure]

BLUTEAU – LARTIGUE PEIP2 | PROJET ARDUINO 2022

AMÉLIORATIONS POSSIBLES

Renforcer la solidité de la boite (utiliser des matériaux plus robustes).

Envoyer une notification au propriétaire de la boite lorsqu’une tentative d’ouverture a eu lieu

Créer un système alternatif d’ouverture en cas de disfonctionnement de la boîte.

## MERCI POUR VOTRE ATTENTION !
