BLUTEAU-LARTIGUE-G4/Security-Box/Rapports Séances/LARTIGUE Elisa/SEANCE 1 LARTIGUE PROJET ARDUINO.pdf

### SEANCE 1 PROJET ARDUINO – ELISA LARTIGUE

Pour cette première séance, je devais m’occuper de verrouillage et de déverrouillage de la boîte puis de l’envoi des informations du pavé numérique sur le terminal. J’ai tout d’abord cherché le fonctionnement du pavé numérique 4x4. Chaque chiffre du pavé numérique est défini comme un numéro de ligne et un numéro de colonne. Les lignes sont branchées sur les entrées 9, 8, 7, 6 et les colonnes 5,4,3,2. Lorsque l’utilisateur appuie sur un chiffre, il crée un contact entre une colonne et une ligne. Par exemple, pour le chiffre 8, la colonne reliée à l’entrée 4 est mise en contact avec la ligne 7.

TRANSFORMATION DU CODE TAPE EN NOMBRE APPARAISSANT SUR LE TERMINAL

J’ai ensuite cherché à faire apparaître les numéros tapés sur le clavier numérique, sur le terminal.

Montage réalisé :

Montage réalisé sur tinkercad car soucis avec une librairie, qui m’empêche de réaliser le montage en vrai

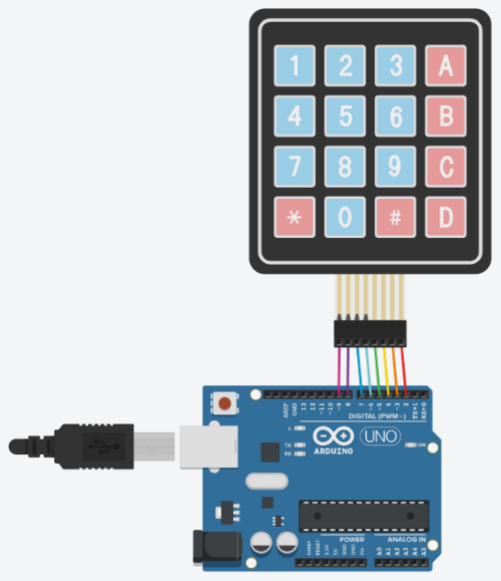
[picture p72: figure]

Code :

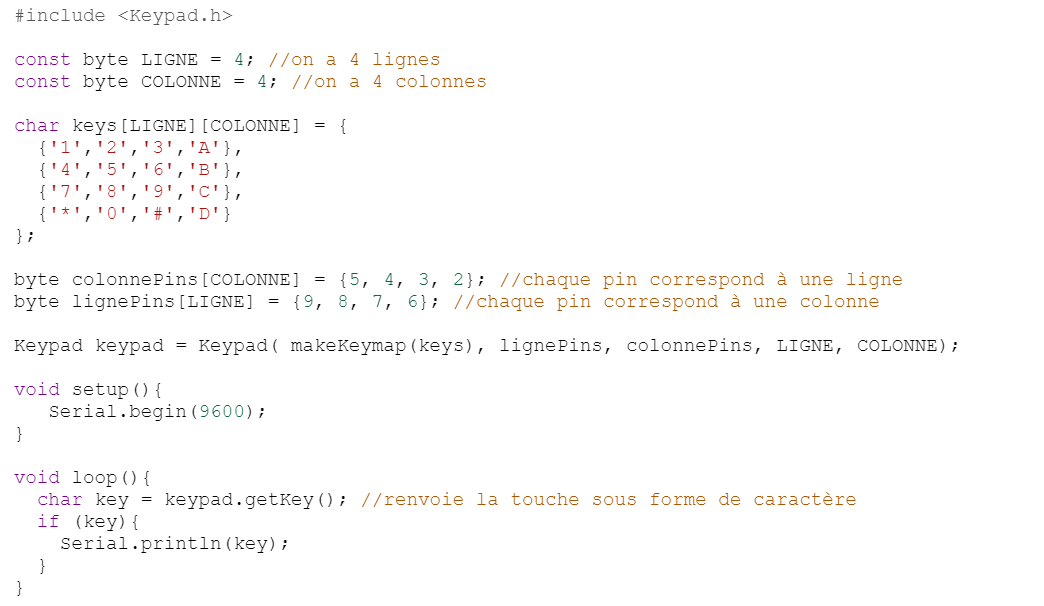
[picture p73: figure]

Exemple de résultats :

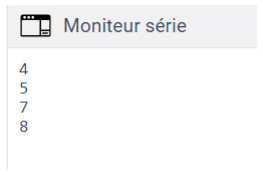
[picture p74: figure]

Problèmes rencontrés :

Le chiffre sur lequel j’appuyais ne correspondait pas au chiffre affiché dans le moniteur série. En effet, c’est comme si j’avais un effet miroir qui se faisait sur la diagonale passant de « * » à « A ». Quand je tapais sur le « 1 », le « D » apparaissait sur le moniteur série. Une mauvaise compréhension du fonctionnement des lignes et des colonnes m’avait amené à nommer mes lignes et colonnes dans le mauvais sens. J’ai donc interverti le sens des chiffres sur la ligne « byte colonnePins[COLONNE] » et sur la ligne « byte lignePins[LIGNE] ».

DEFINITION D’UN CODE ET COMPARAISON AVEC LE CODE ATTENDU

J’ai ensuite dû créer un code qui permet de comparer un code enregistré au préalable (code attendu) à un code tapé par un utilisateur. J’ai donc défini le « code bon » (dans cet exemple 1234). Lorsque je lance le programme, la phrase : « Entrez votre code : » s’affiche. L’utilisateur tape le code. Celui-ci s’affiche lorsqu’il est complet (4 chiffres rentrés). Dans le cas où ce code correspond au code attendu, la phrase « Code bon ! » s’affiche. Si ça n’est pas le cas, l’utilisateur peut retenter à l’infini.

Montage :

Montage réalisé sur tinkercad car soucis avec une librairie, qui m’empêche de réaliser le montage en vrai

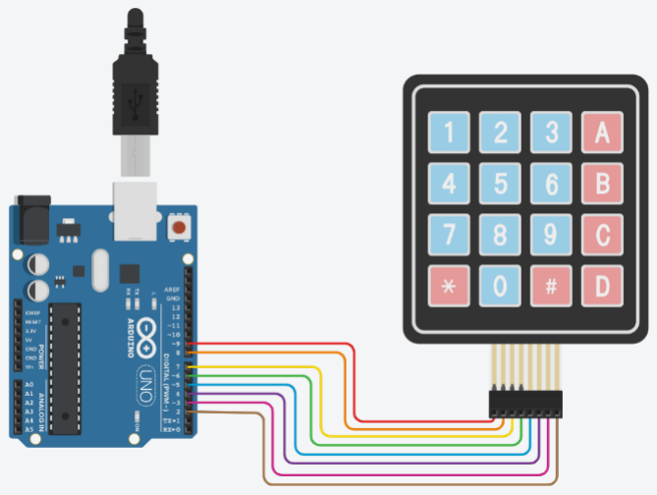
[picture p75: figure]

Code :

J’ai utilisé la librairie Keypad.h et ai récupéré le code précédent que j’ai complété. J’ai choisi une longueur de 4 chiffres pour le code (#define CODE 4). J’ai choisi le code considéré bon : 1234.

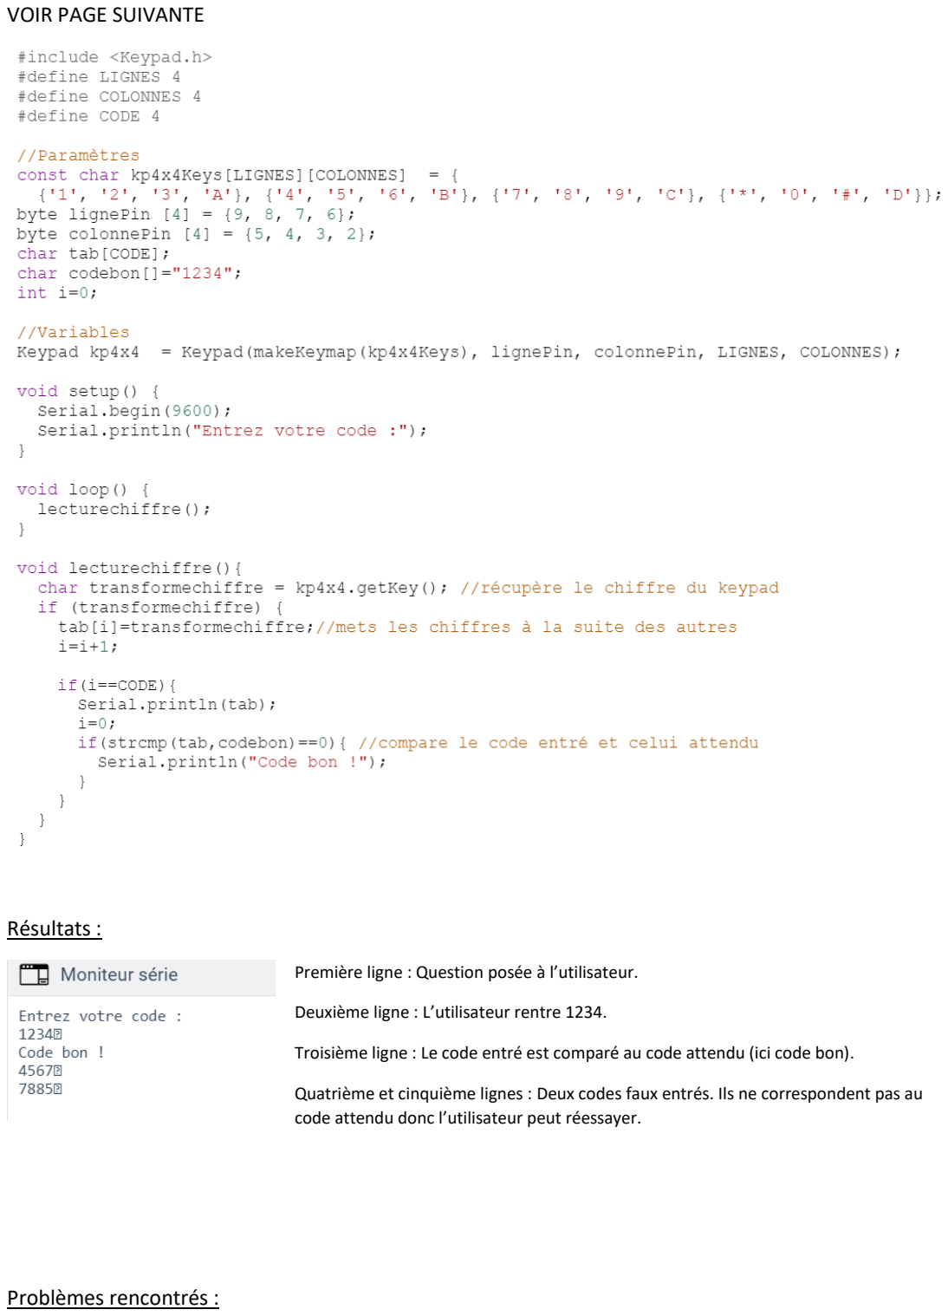
[picture p76: page 3]

VOIR PAGE SUIVANTE

Résultats :

Première ligne : Question posée à l’utilisateur.

Deuxième ligne : L’utilisateur rentre 1234.

Troisième ligne : Le code entré est comparé au code attendu (ici code bon).

Quatrième et cinquième lignes : Deux codes faux entrés. Ils ne correspondent pas au code attendu donc l’utilisateur peut réessayer.

Problèmes rencontrés :

Transformer le code tapé par l’utilisateur en une chaîne de caractère pour que l’ordinateur puisse le comparer au code attendu. J’ai utilisé la fonction strcmp() pour comparer les deux chaînes de caractères. Cette fonction renvoie un 0 si les deux chaînes sont similaires. Le chiffre sur lequel j’appuyais s’affichais 4 fois au lieu d’une. Seuls les codes à 4 chiffres identiques fonctionnaient (1111 ou 2222 par exemple). Apparition d’un point d’interrogation à la fin du code tapé, que je n’arrive pas à enlever.

Sites web utilisés :

Comprendre la fonction strcmp() : https://overiq.com/c-programming-101/the-strcmp-function-inc/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,by%20characte r%20using%20ASCII%20value%20of%20the%20characters. (https://overiq.com/c-programming-101/the-strcmp-function-in-c/)

Comprendre le pavé numérique : https://playground.arduino.cc/Code/Keypad/

Exemple de codes pris à l’appuis : https://www.hackster.io/diy-hacking/arduino-keyless-door-locksystem-with-keypad-and-lcdbcad2e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,The%20initial%20password%20is%201234. (https://www.hackster.io/diy-hacking/arduino-keyless-door-lock-system-with-keypad-and-lcd-bcad2e)

https://www.electroniclinic.com/password-door-lock-security-system-using-arduino-and-keypad/

VOIR LES LIENS DANS LES COMMENTAIRES SUR GITHUB
