BLUTEAU-LARTIGUE-G4/Security-Box/(commit log)

2021-12-11 Add files via upload
    Sites web utilisés :
    Comprendre la fonction strcmp() : https://overiq.com/c-programming-101/the-strcmp-function-in-c/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,by%20character%20using%20ASCII%20value%20of%20the%20characters.
    Comprendre le pavé numérique : https://playground.arduino.cc/Code/Keypad/
    Exemple de codes pris à l’appuis : https://www.hackster.io/diy-hacking/arduino-keyless-door-lock-system-with-keypad-and-lcd-bcad2e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,The%20initial%20password%20is%201234.
    https://www.electroniclinic.com/password-door-lock-security-system-using-arduino-and-keypad/
2021-12-11 Add files via upload
    Liens séance 1 BLUTEAU :
    - https://www.tinkercad.com
    - https://projetsdiy.fr/piloter-servomoteur-arduino/
    - https://www.arduino.cc/en/Tutorial/BuiltInExamples/PhysicalPixel
2021-12-14 Add files via upload
    Liens séance 2 BLUTEAU:
    - https://projetsdiy.fr/programmer-esp8266-ide-arduino-librairies-gpio-web-serveur-client/
    (Lien qui nous a le plus servi)
    - https://projetsdiy.fr/esp8266-client-web-exemples-communication-tcp-ip-esp8266wifi-esp8266httpclient/
    - https://ouilogique.com/pinouts/
2022-01-03 Add files via upload
    Sites utilisés :
    https://randomnerdtutorials.com/?s=esp32+web+server
    https://randomnerdtutorials.com/esp32-pinout-reference-gpios/
2022-01-11 Add files via upload
    liens :
    - https://www.arduino.cc/reference/en/libraries/espsoftwareserial/
    - https://create.arduino.cc/projecthub/nidhi17agarwal/uart-communication-between-arduino-uno-and-esp32-1170d5
    - https://icircuit.net/arduino-interfacing-arduino-uno-esp32/2134
